ErikBakker100/AdjustableCurrentLoad/Referentieontwerpen/Fan_Control/circuit.jpg

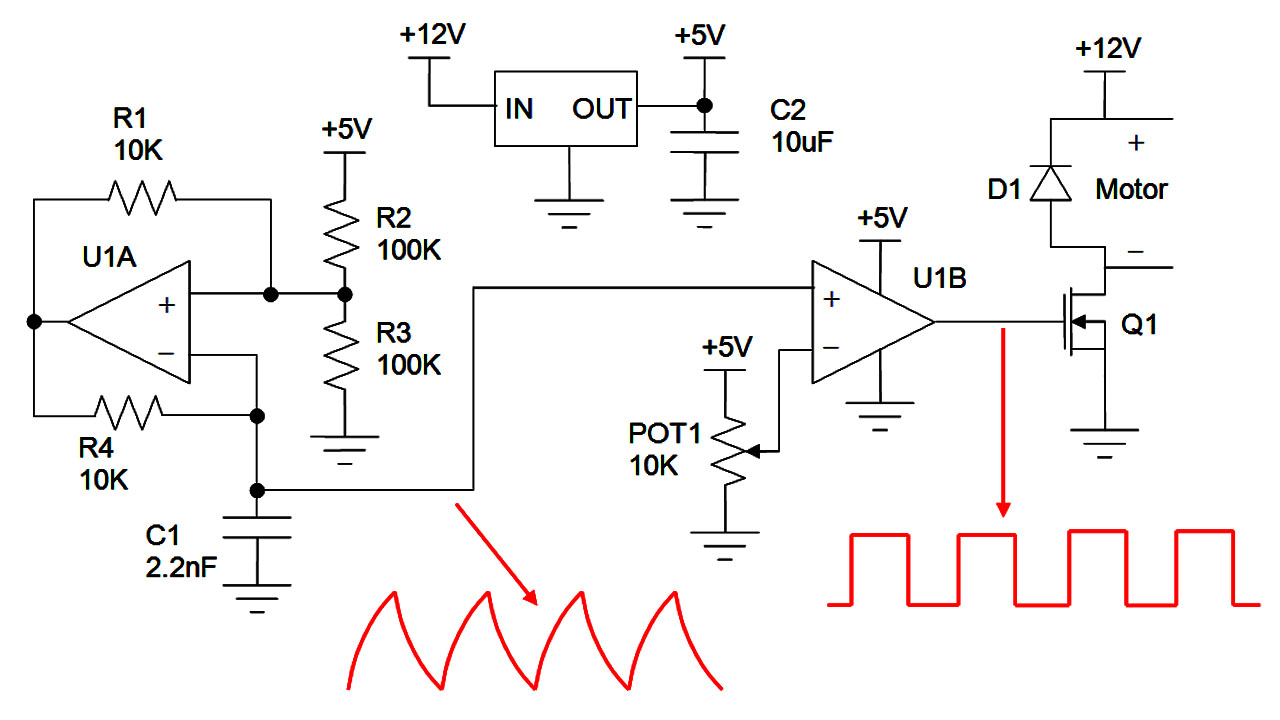
Referentieontwerpen/Fan_Control/circuit.jpg
