ErikBakker100/AdjustableCurrentLoad/Simulatie/FanControl.asc

R1: res; {P}; tol=5
R2: res; 2000; tol=5
R3: res; {R}
R4: res; {P}; tol=5
R5: res; 700; tol=5
R6: res; {R}
V1: voltage; 12
V2: voltage; 12
Named nets: 0, uit_koud, uit_heet
.tran 1
.param R=47k P=1400
