ErikBakker100/AdjustableCurrentLoad/NieuwOntwerp/Load.kicad_pcb

## KiCad design NieuwOntwerp/Load.kicad_pcb (2021-11-21)

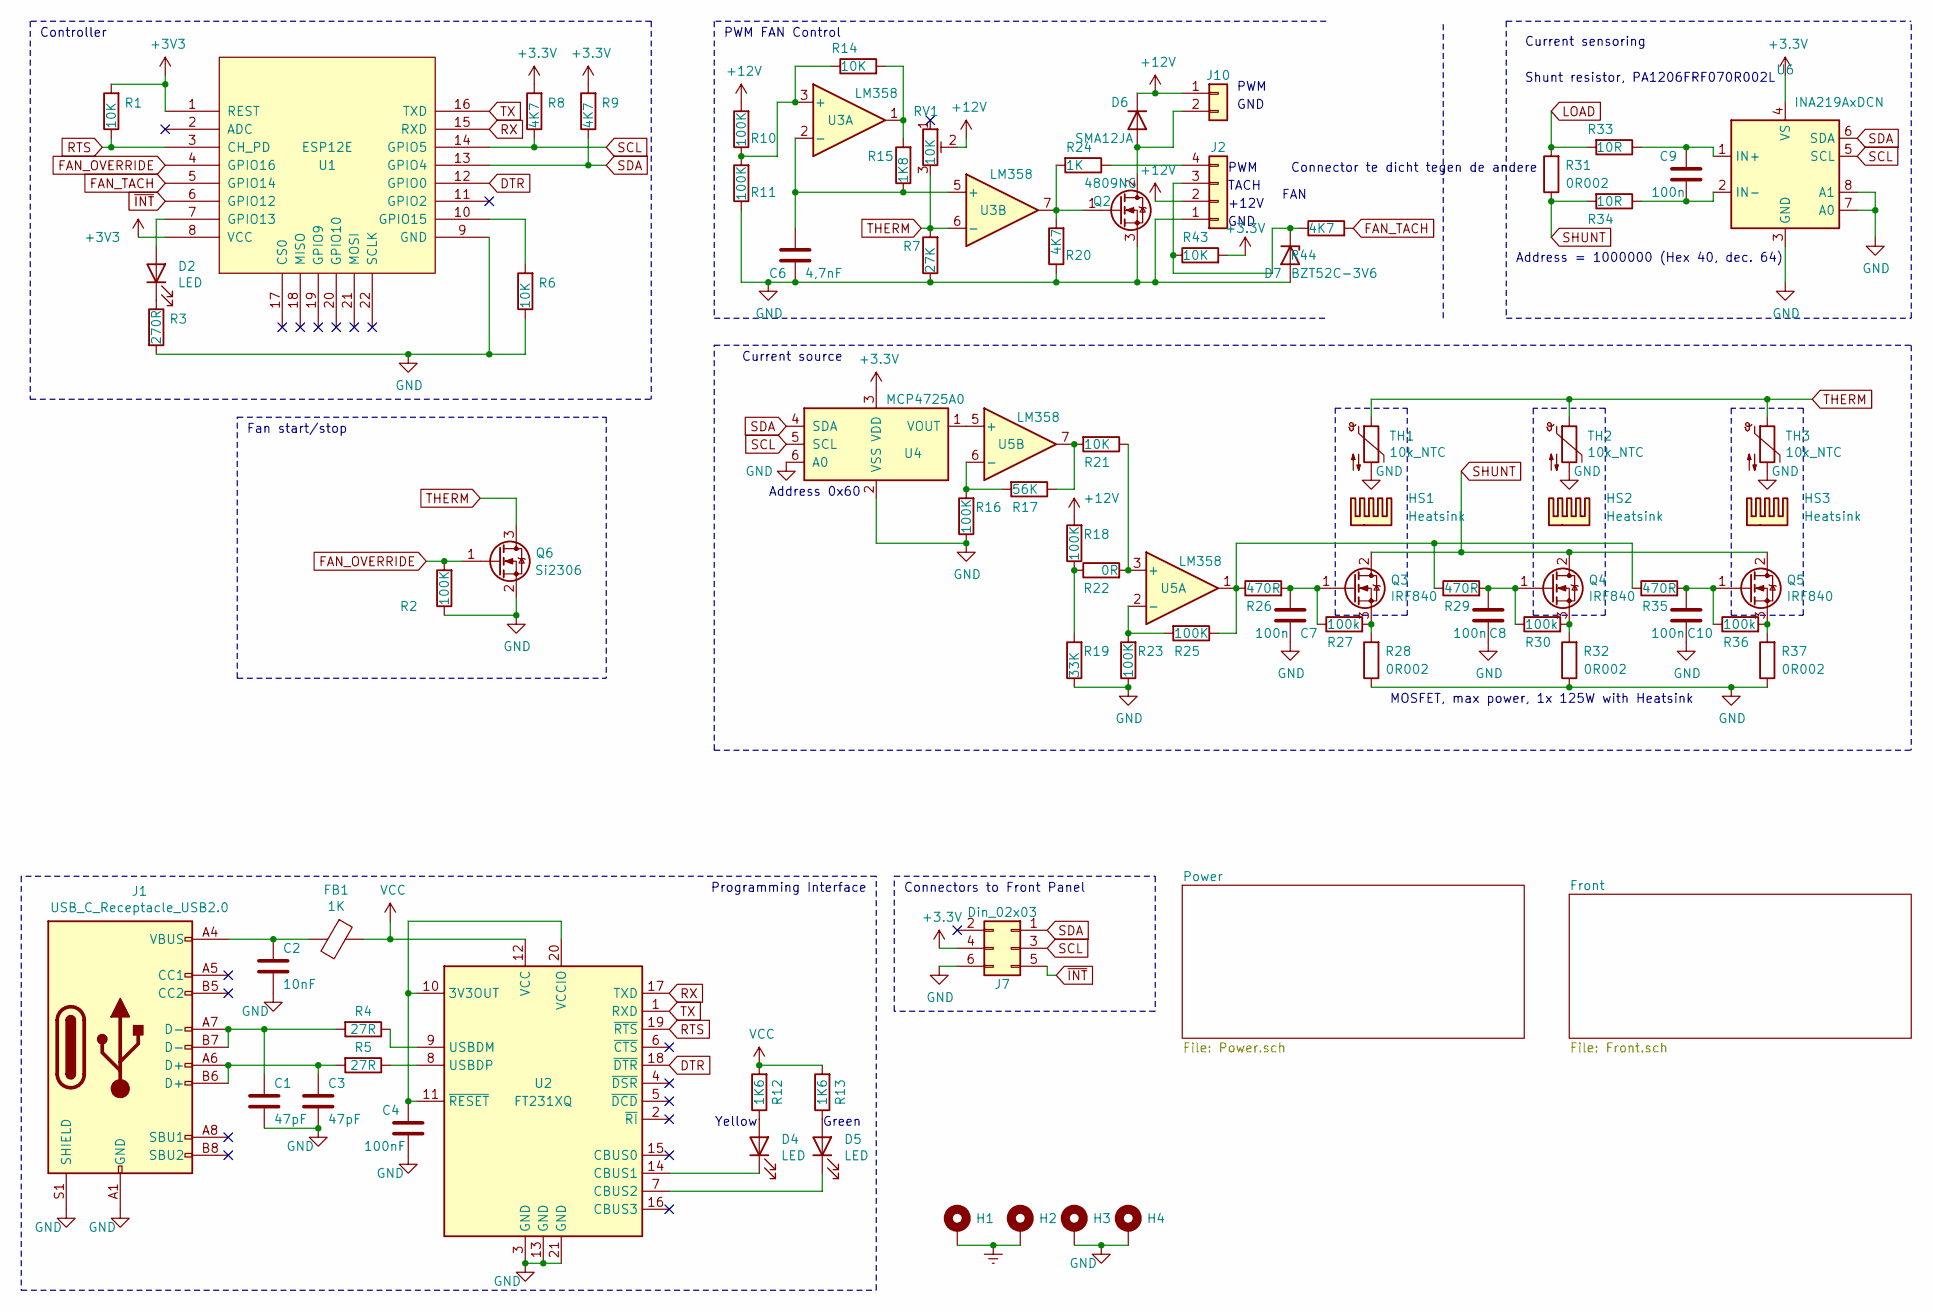
[picture p2: schematic Load.sch, Adjustable Current]

Parts:
C1, C3: 47pF; C_0402_1005Metric
C2: 10nF; C_0402_1005Metric
C4: 100nF; C_0603_1608Metric
C6: 4,7nF; C_0402_1005Metric
C7, C8, C9, C10: 100n; C_0603_1608Metric
D2: LED; LED_0603_1608Metric_Pad1.05x0.95mm_HandSolder
D4, D5: LED; LED_0603_1608Metric
D6: SMA12JA; D_SMA
D7: BZT52C-3V6; D_SOD-123
FB1: 1K; R_0603_1608Metric
H1, H2, H3, H4: MountingHole_Pad; MountingHole_3.2mm_M3_DIN965_Pad
HS1, HS2, HS3: Heatsink; Heatsink_TO220
J1: USB_C_Receptacle_USB2.0; USB-C_Receptable_SMD_16pin
J2: Conn_01x02; JST_XH_B4B-XH-A_1x04_P2.50mm_Vertical
J7: Din_02x03; IDC-Header_2x03_P2.54mm_Vertical
J10: Conn_01x02; JST_XH_B2B-XH-AM_1x02_P2.50mm_Vertical
Q2: 4809NG; 369AA
Q3, Q4, Q5: IRF840; TO-220-3_Vertical
Q6: Si2306; SOT-23
R1, R6, R14, R21, R43: 10K; R_0603_1608Metric
R2, R10, R11, R16, R18, R23, R25: 100K; R_0603_1608Metric
R3: 270R; R_0603_1608Metric
R4, R5: 27R; R_0402_1005Metric
R7: 27K; R_0603_1608Metric
R8, R9, R20, R44: 4K7; R_0603_1608Metric
R12, R13: 1K6; R_0603_1608Metric
R15: 1K8; R_0603_1608Metric
R17: 56K; R_0603_1608Metric
R19: 33K; R_0603_1608Metric
R22: 0R; R_0603_1608Metric
R24: 1K; R_0603_1608Metric
R26, R29, R35: 470R; R_0603_1608Metric
R27, R30, R36: 100k; R_0603_1608Metric
R28, R31, R32, R37: 0R002; R_1206_3216Metric
R33, R34: 10R; R_0603_1608Metric
RV1: 10K; Potentiometer_Bourns_3296W_Vertical
TH1, TH2, TH3: 10k_NTC; THERM_NXRT15XH103FA1B040
U1: ESP12E; ESP-12E_SMD
U2: FT231XQ; QFN-20-1EP_4x4mm_P0.5mm_EP2.5x2.5mm
U3, U5: LM358; SOIC-8_3.9x4.9mm_P1.27mm
U4: MCP4725A0; SOT-23-6
U6: INA219AxDCN; SOT-23-8

Connections:
+12V: D6.1 (K), J2.2, J10.1, R10.2, R18.2, RV1.2; also elsewhere on the board
DTR: U1.12 (GPIO0), U2.18 (~DTR)
Earth: H1.1, H2.1; also elsewhere on the board
FAN_OVERRIDE: Q6.1 (G), R2.2, U1.4 (GPIO16)
FAN_TACH: R44.2, U1.5 (GPIO14)
GND: C1.2, C2.2, C3.2, C4.2, C6.1, C7.1, C8.1, C10.1, D7.2 (A), H3.1, H4.1, J1.A1 (GND), J1.A12 (GND), J1.B1 (GND), J1.B12 (GND), J1.S1 (SHIELD), J2.1, J7.6, Q2.3 (S), Q6.2 (S), R2.1, R3.2, R6.1, R7.1, R11.1, R16.1, R19.1, R20.1, R23.1, R28.1, R32.1, R37.1, TH1.2, TH2.2, TH3.2, U1.9 (GND), U2.3 (GND), U2.13 (GND), U2.21 (GND), U4.2 (VSS), U4.6 (A0), U6.3 (GND), U6.7 (A0), U6.8 (A1); also elsewhere on the board
LOAD: R31.2, R33.2; also elsewhere on the board
unnamed: C1.1, J1.A7 (D-), J1.B7 (D-), R4.2
unnamed: C2.1, FB1.2, J1.A4 (VBUS), J1.A9 (VBUS), J1.B4 (VBUS), J1.B9 (VBUS)
unnamed: C3.1, J1.A6 (D+), J1.B6 (D+), R5.2
unnamed: C4.1, U2.10 (3V3OUT), U2.11 (~RESET), U2.20 (VCCIO)
unnamed: C6.2, R15.1, U3.2 (-), U3.5 (+)
unnamed: C7.2, Q3.1 (G), R26.2, R27.1
unnamed: C8.2, Q4.1 (G), R29.2, R30.1
unnamed: C9.1, R33.1, U6.1 (IN+)
unnamed: C9.2, R34.1, U6.2 (IN-)
unnamed: C10.2, Q5.1 (G), R35.2, R36.1
unnamed: D2.1 (K), R3.1
unnamed: D2.2 (A), U1.7 (GPIO13)
unnamed: D4.1 (K), U2.14 (CBUS1)
unnamed: D4.2 (A), R12.1
unnamed: D5.1 (K), U2.7 (CBUS2)
unnamed: D5.2 (A), R13.1
unnamed: D6.2 (A), J10.2, Q2.2 (D)
unnamed: D7.1 (K), J2.3, R43.1, R44.1
unnamed: J2.4, R24.1
unnamed: Q2.1 (G), R20.2, R24.2, U3.7
unnamed: Q3.3 (S), R27.2, R28.2
unnamed: Q4.3 (S), R30.2, R32.2
unnamed: Q5.3 (S), R36.2, R37.2
unnamed: R4.1, U2.9 (USBDM)
unnamed: R5.1, U2.8 (USBDP)
unnamed: R6.2, U1.10 (GPIO15)
unnamed: R10.1, R11.2, R14.1, U3.3 (+)
unnamed: R14.2, R15.2, U3.1
unnamed: R16.2, R17.2, U5.6 (-)
unnamed: R17.1, R21.2, U5.7
unnamed: R18.1, R19.2, R22.1
unnamed: R21.1, R22.2, U5.3 (+)
unnamed: R23.2, R25.2, U5.2 (-)
unnamed: R25.1, R26.1, R29.1, R35.1, U5.1
unnamed: U4.1 (VOUT), U5.5 (+)
RTS: R1.1, U1.3 (CH_PD), U2.19 (~RTS)
RX: U1.15 (RXD), U2.17 (TXD)
SCL: J7.3, R8.1, U1.14 (GPIO5), U4.5 (SCL), U6.5 (SCL)
SDA: J7.1, R9.1, U1.13 (GPIO4), U4.4 (SDA), U6.6 (SDA)
SHUNT: Q3.2 (D), Q4.2 (D), Q5.2 (D), R31.1, R34.2
THERM: Q6.3 (D), R7.2, RV1.3, TH1.1, TH2.1, TH3.1, U3.6 (-)
TX: U1.16 (TXD), U2.1 (RXD)
VCC: FB1.1, R12.2, R13.2, U2.12 (VCC); also elsewhere on the board
~INT: J7.5, U1.6 (GPIO12)

Notes on the sheet:
Address = 1000000 (Hex 40, dec. 64)
Shunt resistor, PA1206FRF070R002L
Current sensoring
MOSFET, max power, 1x 125W with Heatsink
Current source
Controller
Address 0x60
Yellow
Green
Programming Interface
FAN
GND
+12V
TACH
PWM
PWM FAN Control
Fan start/stop
Connectors to Front Panel
Connector te dicht tegen de andere

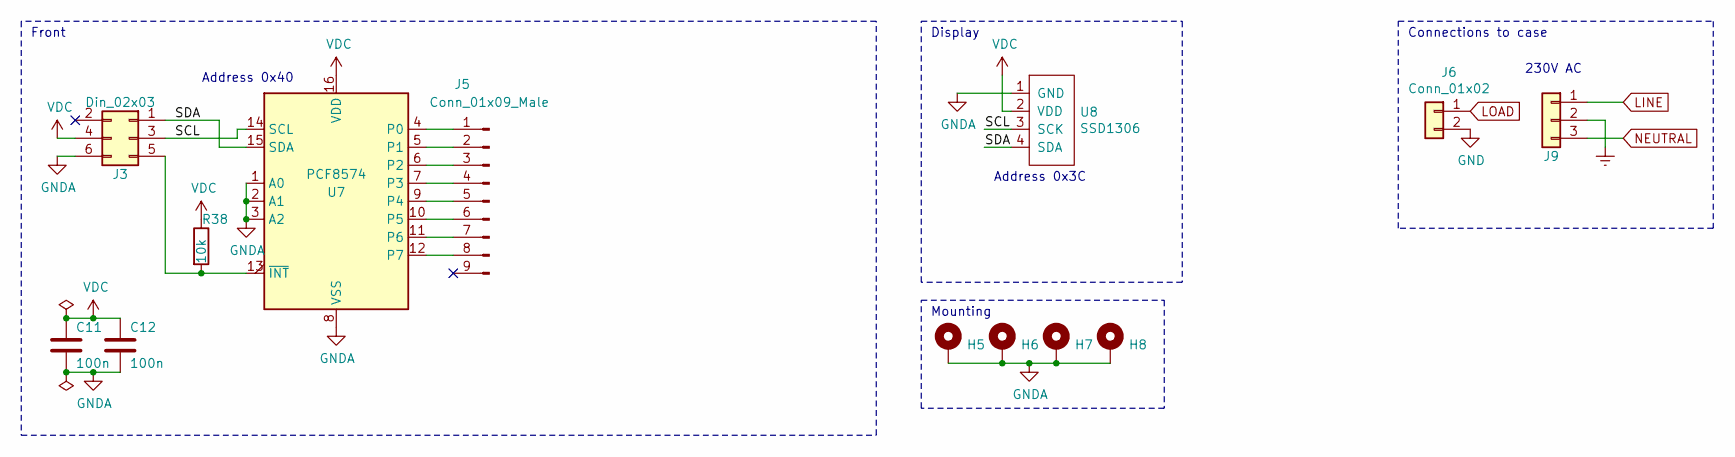
[picture p3: schematic Front.sch, Control_Panel]

Parts:
C11, C12: 100n; C_0603_1608Metric
H5, H6, H7, H8: MountingHole_Pad; MountingHole_3.2mm_M3_Pad
J3: Din_02x03; IDC-Header_2x03_P2.54mm_Vertical
J5: Conn_01x09_Male; PinHeader_1x09_P2.54mm_Vertical
J6: Conn_01x02; JST_XH_B2B-XH-AM_1x02_P2.50mm_Vertical
J9: Conn_01x02; JST_XH_B3B-XH-AM_1x03_P2.50mm_Vertical
R38: 10k; R_0603_1608Metric
U7: PCF8574; SOIC-16W_7.5x10.3mm_P1.27mm
U8: SSD1306

Connections:
/Front/SCL: J3.3, U7.14 (SCL), U8.3 (SCK)
/Front/SDA: J3.1, U7.15 (SDA), U8.4 (SDA)
Earth: J9.2; also elsewhere on the board
GND: J6.2; also elsewhere on the board
GNDA: C11.1, C12.1, H5.1, H6.1, H7.1, H8.1, J3.6, U7.1 (A0), U7.2 (A1), U7.3 (A2), U7.8 (VSS), U8.1 (GND)
LINE: J9.1; also elsewhere on the board
LOAD: J6.1; also elsewhere on the board
NEUTRAL: J9.3; also elsewhere on the board
unnamed: J3.5, R38.2, U7.13 (~INT~)
unnamed: J5.1, U7.4 (P0)
unnamed: J5.2, U7.5 (P1)
unnamed: J5.3, U7.6 (P2)
unnamed: J5.4, U7.7 (P3)
unnamed: J5.5, U7.9 (P4)
unnamed: J5.6, U7.10 (P5)
unnamed: J5.7, U7.11 (P6)
unnamed: J5.8, U7.12 (P7)
VDC: C11.2, C12.2, J3.4, R38.1, U7.16 (VDD), U8.2 (VDD)

Notes on the sheet:
Display
Address 0x3C
Address 0x40
Front
Mounting
230V AC
Connections to case

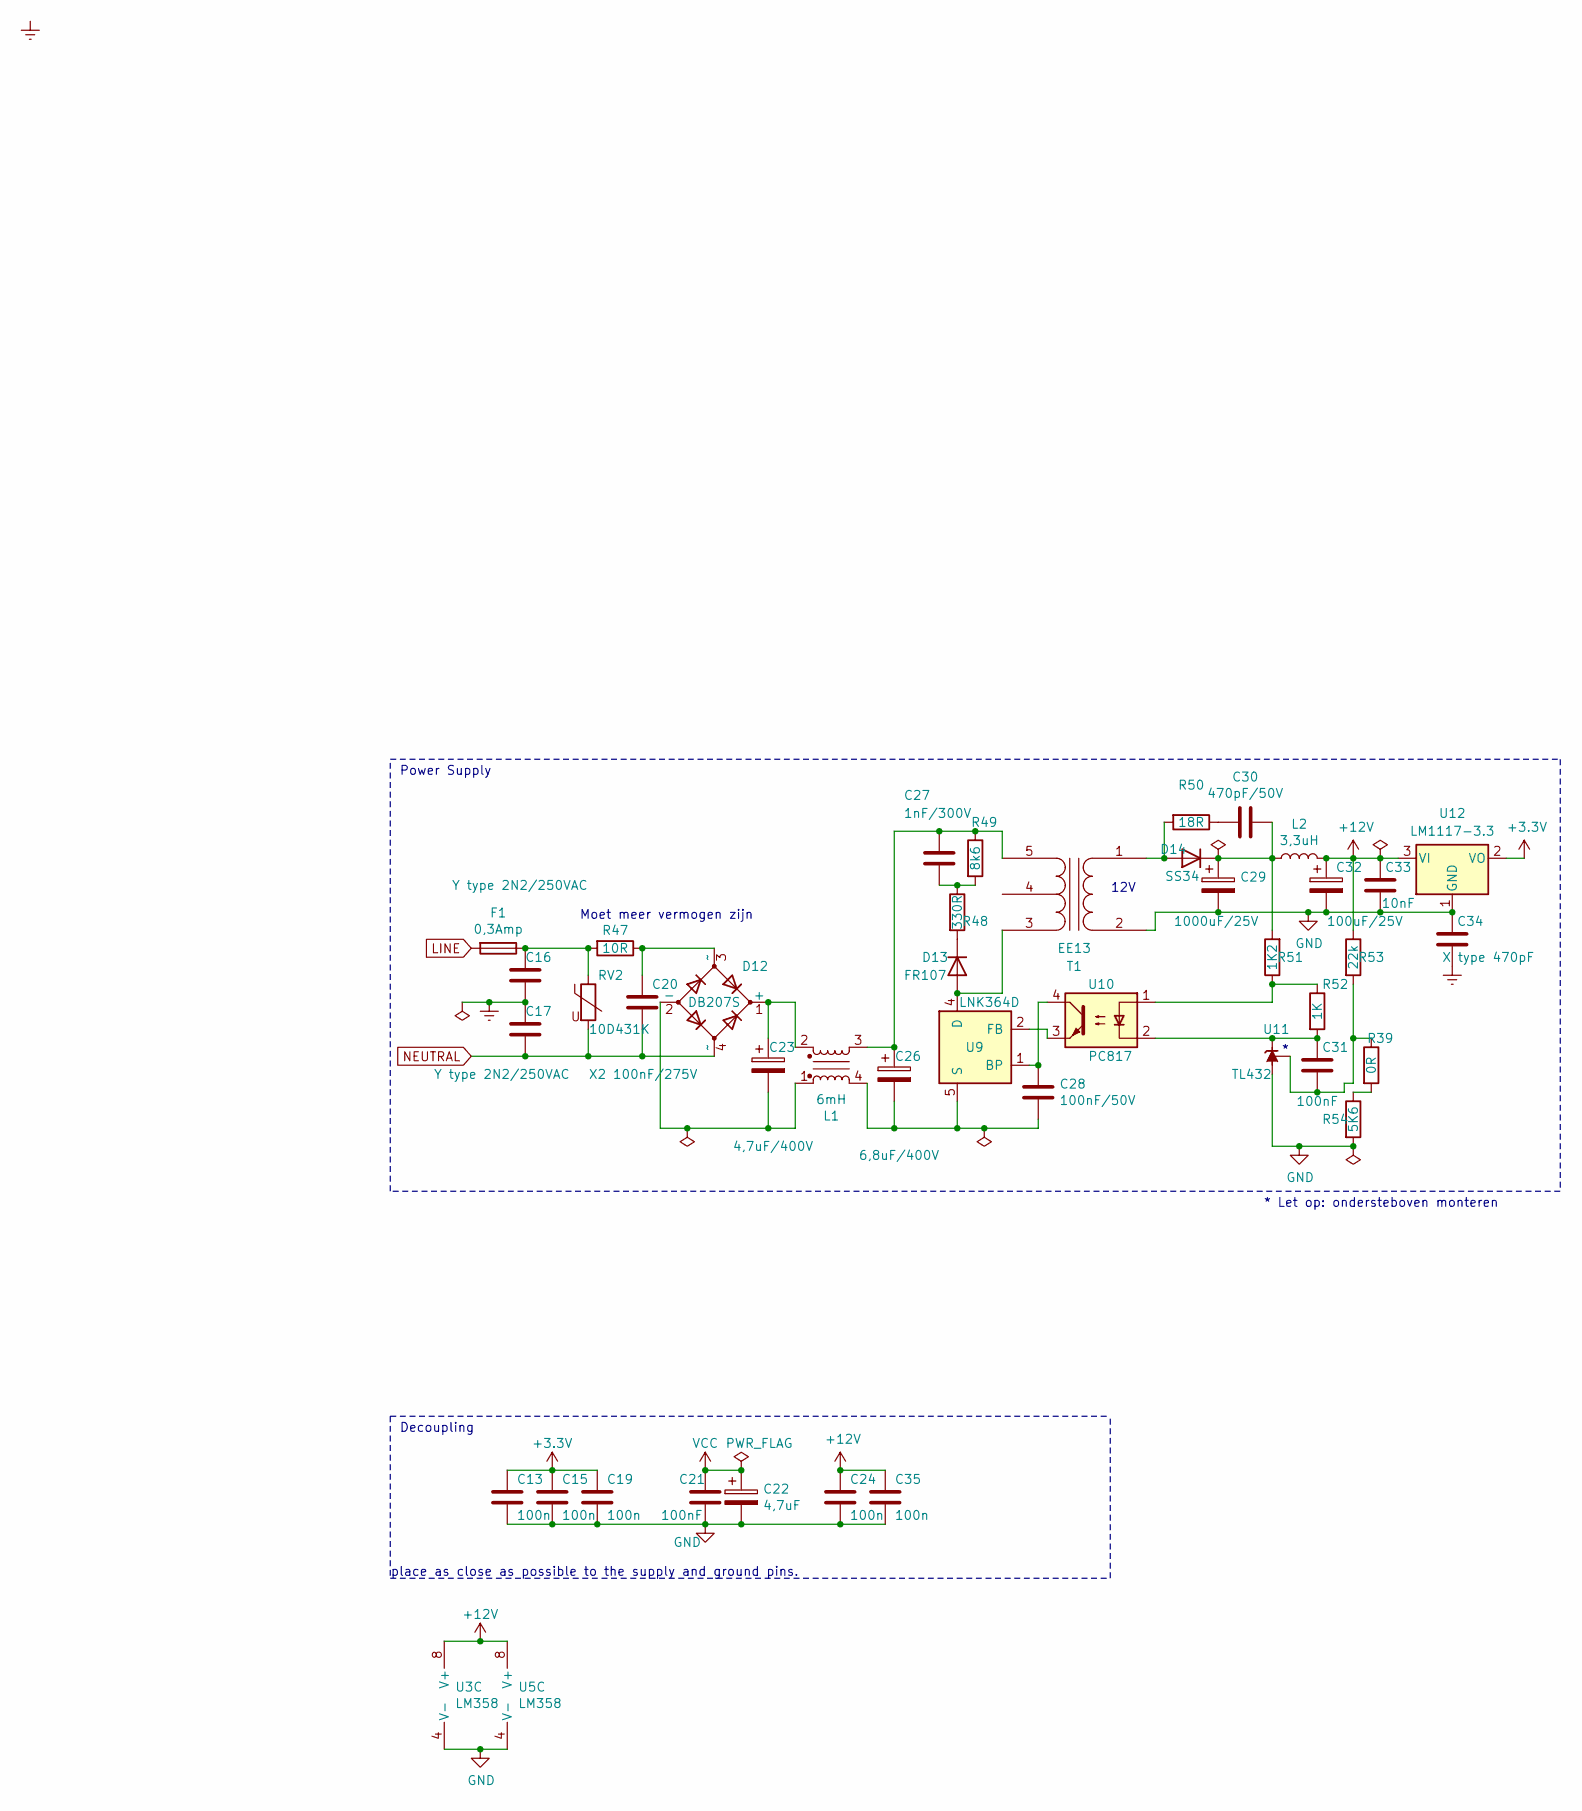
[picture p4: schematic Power.sch]

Parts:
C13, C15, C19, C24, C35: 100n; C_0603_1608Metric
C16, C17: Y type 2N2/250VAC; Y2_222
C20: X2 100nF/275V; CBB22104J400V
C21, C31: 100nF; C_0603_1608Metric
C22: 4,7uF; C_Elec_4x5.4
C23: 4,7uF/400V; CP_Radial_D8.0mm_P3.50mm
C26: 6,8uF/400V; CP_Radial_D8.0mm_P3.50mm
C27: 1nF/300V; JN_102M
C28: 100nF/50V; C_0603_1608Metric
C29: 1000uF/25V; CP_Radial_D10.0mm_P5.00mm
C30: 470pF/50V; C_0603_1608Metric
C32: 100uF/25V; CP_Radial_D5.0mm_P2.00mm
C33: 10nF; C_0603_1608Metric
C34: X type 470pF; JN_102M
D12: DB207S; SOT4_Rectifier_Bridge
D13: FR107; D_SMA
D14: SS34; D_SMA
F1: 0,3Amp; fuse-clip-5x20mm
L1: 6mH; UU98_Common_Mode_Choke
L2: 3,3uH; L_1206_3216Metric
R39: 0R; R_0603_1608Metric
R47: 10R; R_Axial_DIN0411_L9.9mm_D3.6mm_P5.08mm_Vertical
R48: 330R; R_Axial_DIN0207_L6.3mm_D2.5mm_P2.54mm_Vertical
R49: 8k6; R_Axial_DIN0207_L6.3mm_D2.5mm_P2.54mm_Vertical
R50: 18R; R_1206_3216Metric
R51: 1K2; R_0603_1608Metric
R52: 1K; R_0603_1608Metric
R53: 22k; R_0402_1005Metric
R54: 5K6; R_0603_1608Metric
RV2: 10D431K; RV_Disc_D10mm_W2mm_P8mm
T1: EE13; EE16-A2
U3, U5: LM358; SOIC-8_3.9x4.9mm_P1.27mm
U9: LNK364D; PowerIntegrations_SO-8C
U10: PC817; SSO-4_6.7x5.1mm_P2.54mm_Clearance8mm
U11: TL432; SOT-23
U12: LM1117-3.3; SOT-223-3_TabPin2

Connections:
+12V: C24.2, C32.1, C33.1, C35.2, L2.2, R53.1, U3.8 (V+), U5.8 (V+), U12.3 (VI); also elsewhere on the board
Earth: C16.1, C17.2, C34.1; also elsewhere on the board
GND: C13.1, C15.1, C19.1, C21.2, C22.2, C24.1, C29.2, C32.2, C33.2, C34.2, C35.1, R54.2, T1.2 (AB), U3.4 (V-), U5.4 (V-), U11.3 (A), U12.1 (GND); also elsewhere on the board
LINE: F1.2; also elsewhere on the board
NEUTRAL: C17.1, C20.2, D12.4 (~~), RV2.2; also elsewhere on the board
unnamed: C16.2, F1.1, R47.2, RV2.1
unnamed: C20.1, D12.3 (~~), R47.1
unnamed: C23.1, D12.1 (+), L1.2
unnamed: C23.2, D12.2 (-), L1.1
unnamed: C26.1, C27.1, L1.3, R49.1, T1.5 (SB)
unnamed: C26.2, C28.2, L1.4, U9.5 (S), U9.6 (S), U9.7 (S), U9.8 (S)
unnamed: C27.2, R48.1, R49.2
unnamed: C28.1, U9.1 (BP), U10.4
unnamed: C29.1, C30.1, D14.1 (K), L2.1, R51.2
unnamed: C30.2, R50.1
unnamed: C31.1, R52.2, U10.2, U11.1 (K)
unnamed: C31.2, R39.1, R53.2, U11.2 (REF)
unnamed: D13.1 (K), R48.2
unnamed: D13.2 (A), T1.3 (SA), U9.4 (D)
unnamed: D14.2 (A), R50.2, T1.1 (AA)
unnamed: R39.2, R54.1
unnamed: R51.1, R52.1, U10.1
unnamed: U9.2 (FB), U10.3
VCC: C21.1, C22.1; also elsewhere on the board

Notes on the sheet:
12V
Power Supply
place as close as possible to the supply and ground pins.
Decoupling
* Let op: ondersteboven monteren
Moet meer vermogen zijn

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
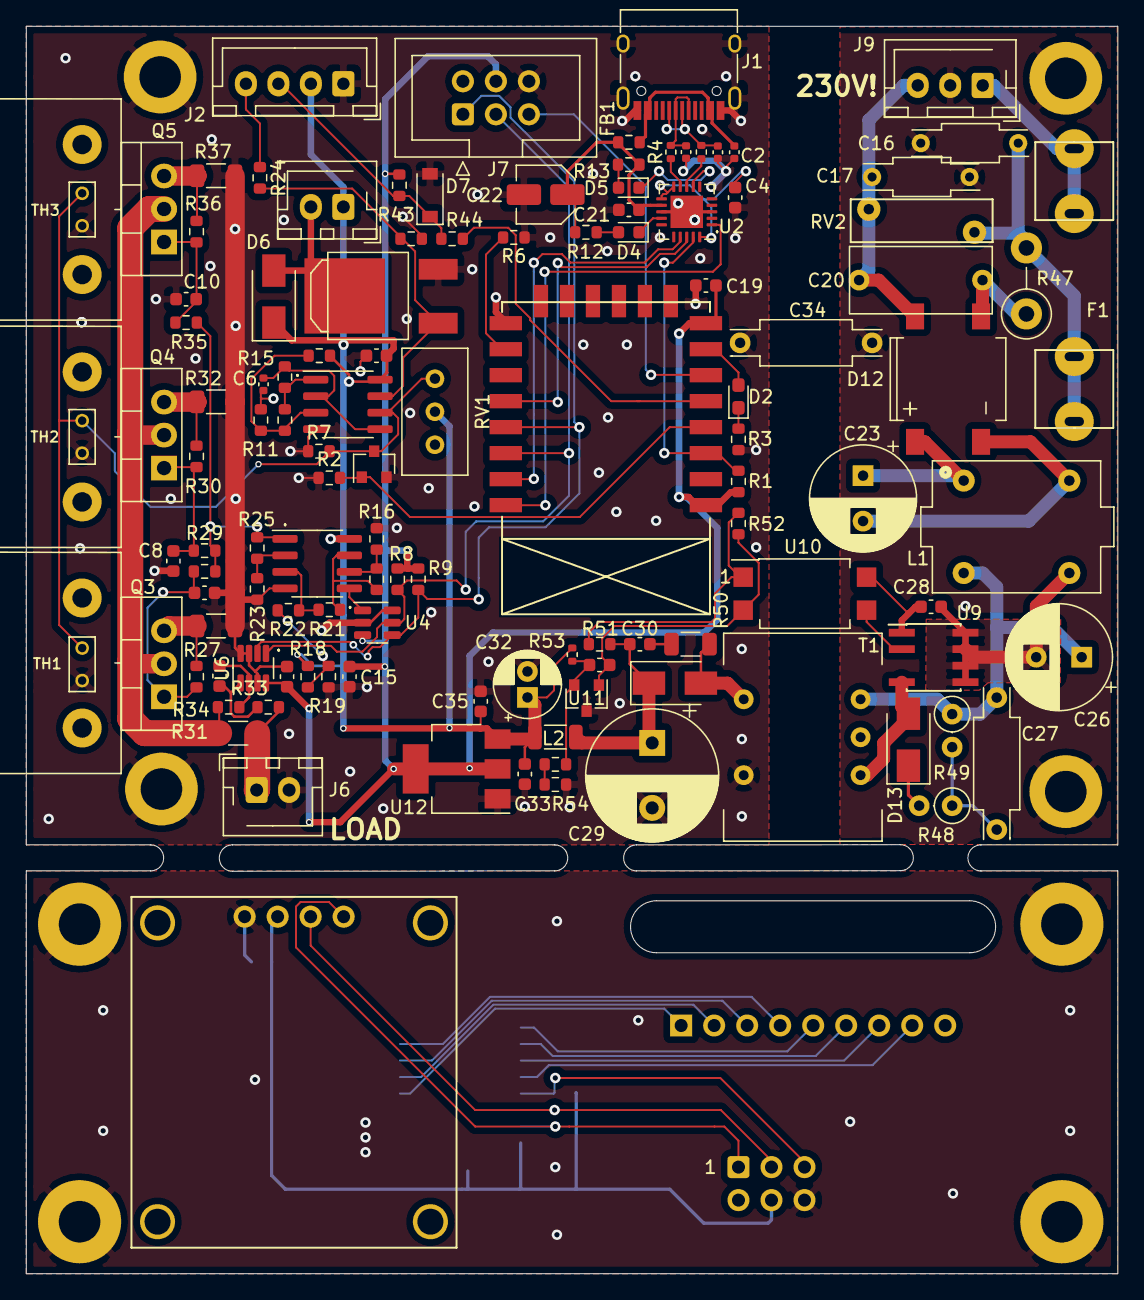
[picture p5: board Load.kicad_pcb from above]

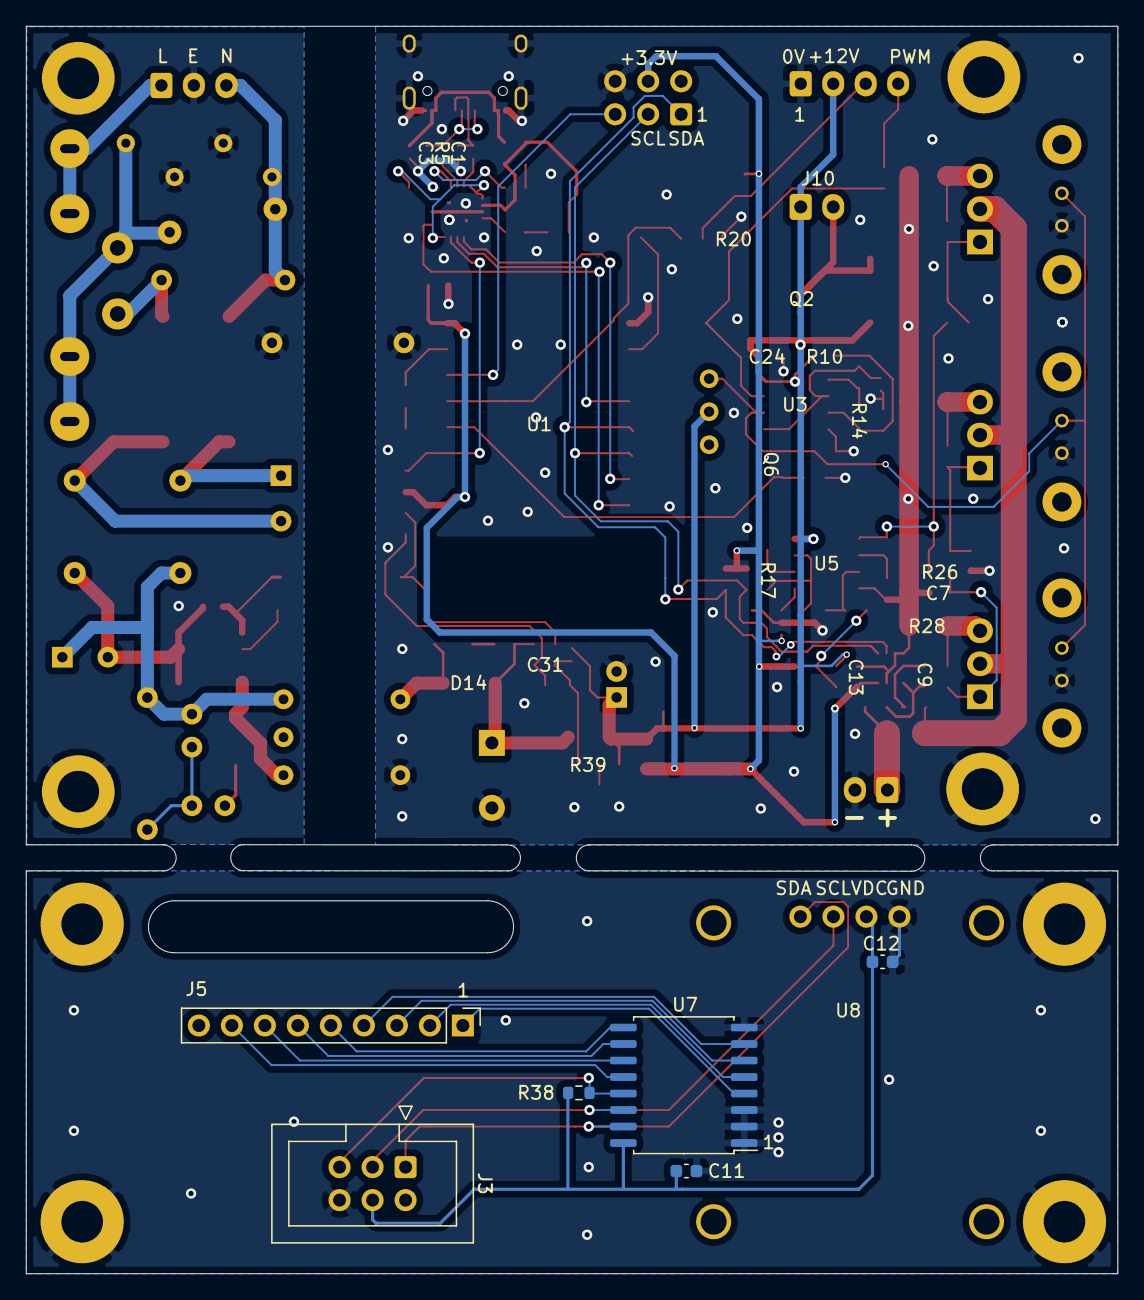
[picture p6: board Load.kicad_pcb from below]

Board: 2 copper layers, 84.0 x 96.0 mm, 134 parts (6 on the bottom side), 85 nets.
