ErikBakker100/AdjustableCurrentLoad/(commit log)

2021-09-19 Keypad OK
    [Load.sch]
2021-09-19 MCP4725 BEGIN
    [Load.sch]
2021-09-20 INA Begin
    [Load.kicad_pcb]
2021-10-23 print update
    [Load.kicad_pcb, Load.sch]
2021-10-24 Print gereed
    [Load.kicad_pcb]
